dylanler/flour-dispenser-assembly/public/hardware/README.txt

Current build: V3.2. Open BUILD_GUIDE_V3_2.html.
Reprint only hopper/gate from servo-fit/V3_2_REPAIR_PLATE_HOPPER_GATE_PACKING.3mf; retain stand/lid/clips.
Wiring: wiring/WIRING_GUIDE.html. MicroPython: repository docs/SOFTWARE.md.
No servo-ear shims; supplied horn seats first, optional packing under horn arms in gate. Physically unverified prototype.
