dylanler/flour-dispenser-assembly/public/hardware/one_plate_preview.png

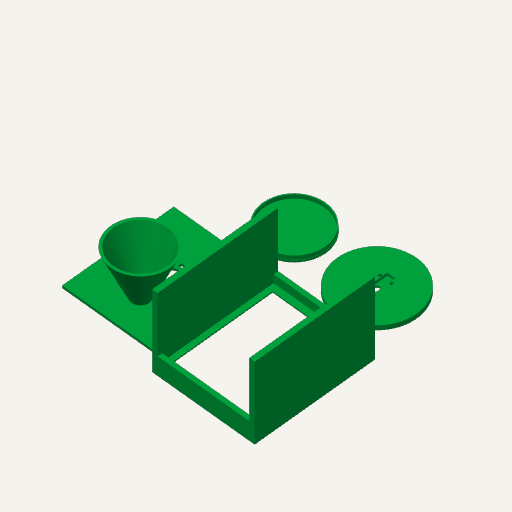
public/hardware/one_plate_preview.png
