dylanler/flour-dispenser-assembly/public/hardware/one_plate_preview_v3.png

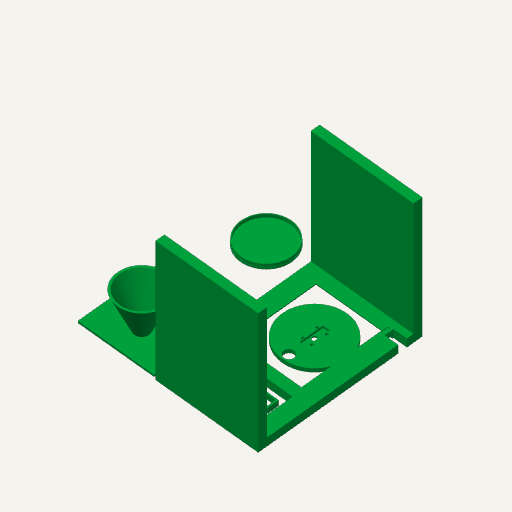
public/hardware/one_plate_preview_v3.png
