dylanler/flour-dispenser-assembly/public/hardware/simulation/overview.png

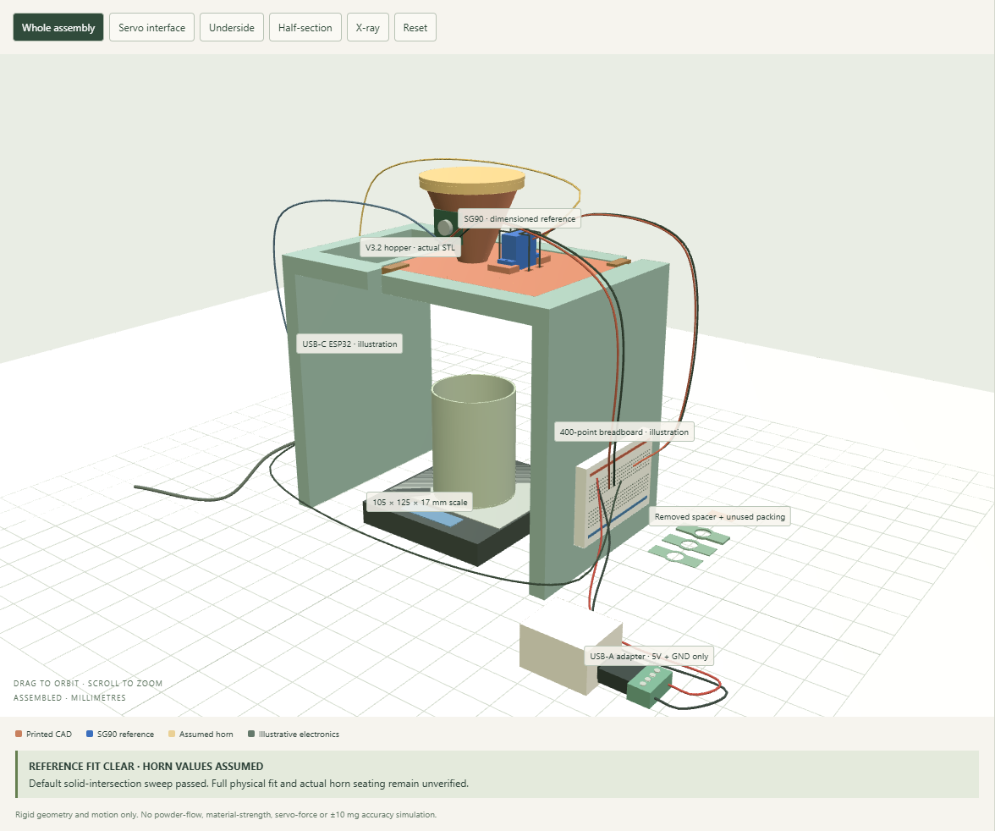
public/hardware/simulation/overview.png
