dylanler/flour-dispenser-assembly/public/hardware/simulation/section.png

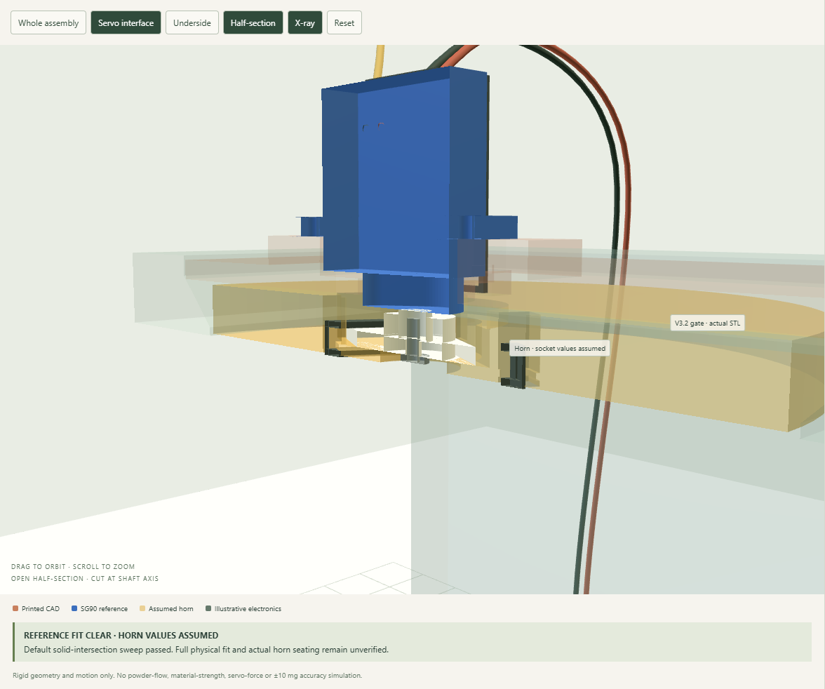
public/hardware/simulation/section.png
