dylanler/flour-dispenser-assembly/public/hardware/top_preview.png

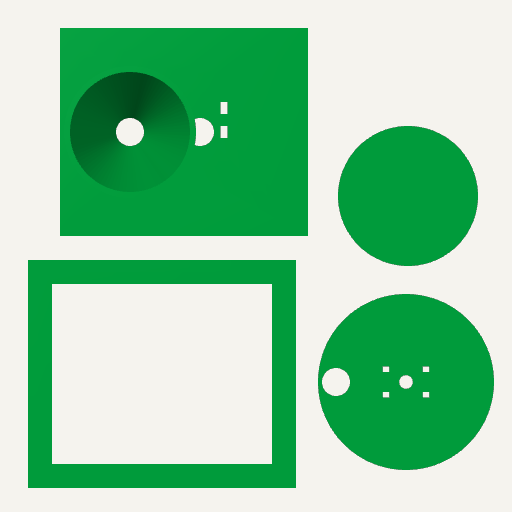
public/hardware/top_preview.png
