dylanler/flour-dispenser-assembly/public/hardware/top_preview_v3.png

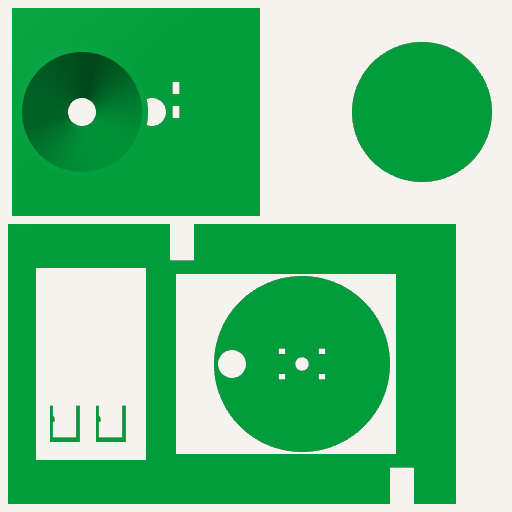
public/hardware/top_preview_v3.png
