dylanler/flour-dispenser-assembly/public/hardware/V3_ASSEMBLED_REFERENCE_DO_NOT_PRINT.stl

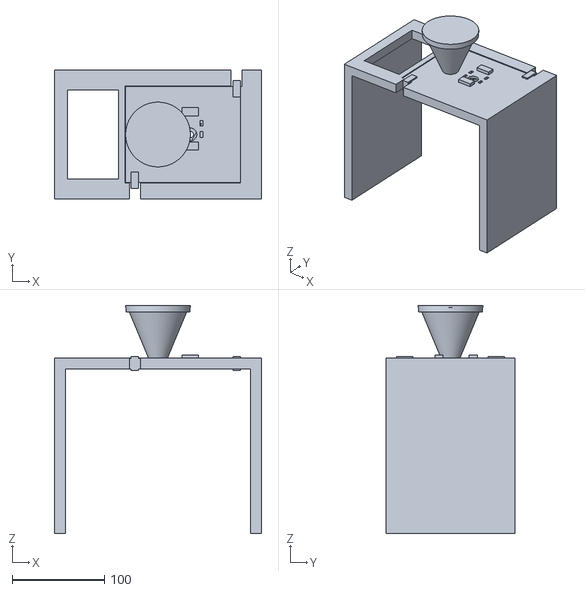
[picture p9: CAD file, 2026-11-04]
public/hardware/V3_ASSEMBLED_REFERENCE_DO_NOT_PRINT.stl
224.0 x 140.0 x 246.7
