dylanler/flour-dispenser-assembly/public/hardware/servo-fit/11_ASSEMBLY_GAP_SPACER_0p6_V3_2.stl

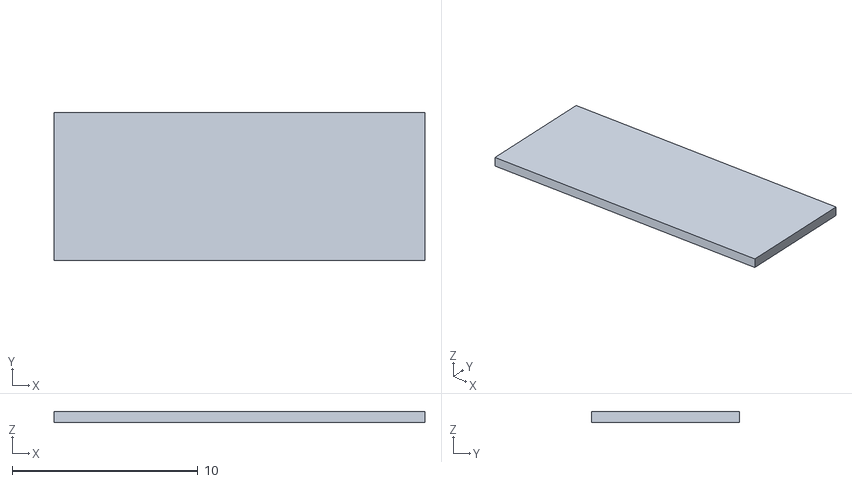
[picture p10: CAD file, 2026-11-10]
public/hardware/servo-fit/11_ASSEMBLY_GAP_SPACER_0p6_V3_2.stl
20.0 x 8.00 x 0.6
