dylanler/flour-dispenser-assembly/public/hardware/simulation/front_clip_assembled.stl

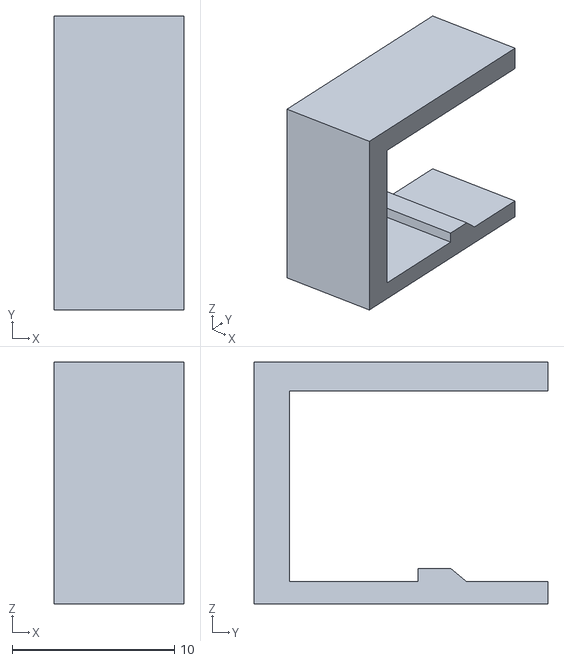
[picture p11: CAD file, 2026-11-10]
public/hardware/simulation/front_clip_assembled.stl
8.00 x 18.1 x 14.9
