dylanler/flour-dispenser-assembly/public/hardware/A1_V3_WIDE_ONE_PLATE.3mf

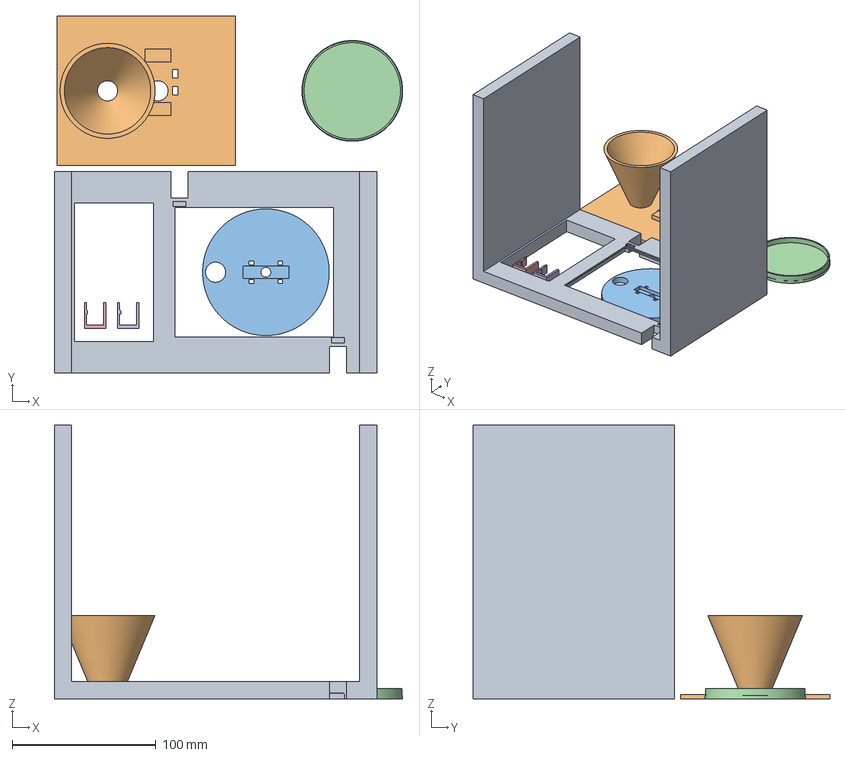
[picture p12: CAD file, 2026-11-04]
public/hardware/A1_V3_WIDE_ONE_PLATE.3mf
242.0 x 248.0 x 190.0 mm
01_wide_cradle
02_hopper_with_servo_mount
03_rotary_gate
04_lid
05_locking_clip x 2
