dylanler/flour-dispenser-assembly/public/hardware/servo-fit/09_GATE_ADJUSTABLE_HORN_V3_2.stl

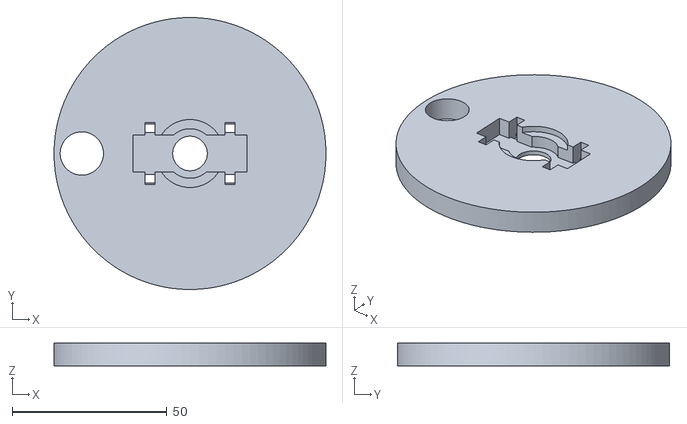
[picture p13: CAD file, 2026-11-10]
public/hardware/servo-fit/09_GATE_ADJUSTABLE_HORN_V3_2.stl
88.0 x 88.0 x 7.40
