dylanler/flour-dispenser-assembly/public/hardware/simulation/servo_ears.stl

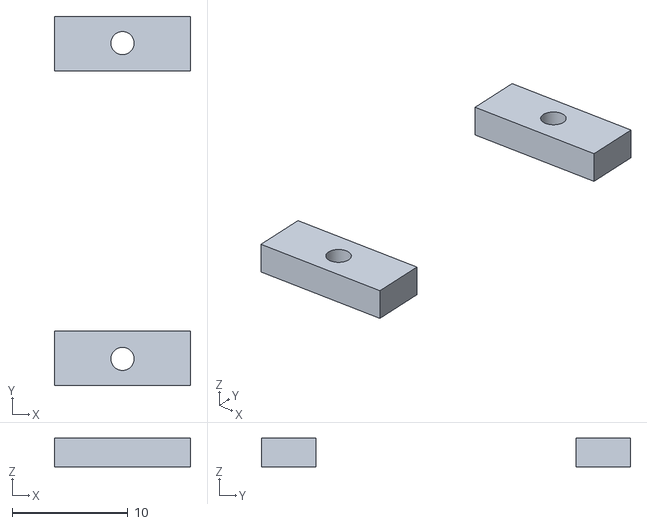
[picture p14: CAD file, 2026-11-10]
public/hardware/simulation/servo_ears.stl
11.8 x 31.9 x 2.50
