dylanler/flour-dispenser-assembly/public/hardware/stl/01_wide_cradle.stl

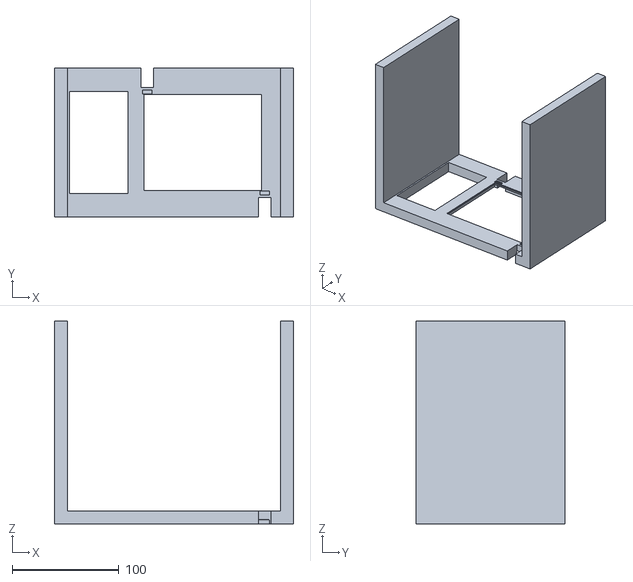
[picture p15: CAD file, 2026-11-04]
public/hardware/stl/01_wide_cradle.stl
224.0 x 140.0 x 190.0
