dylanler/flour-dispenser-assembly/public/hardware/simulation/horn_arms_35.stl

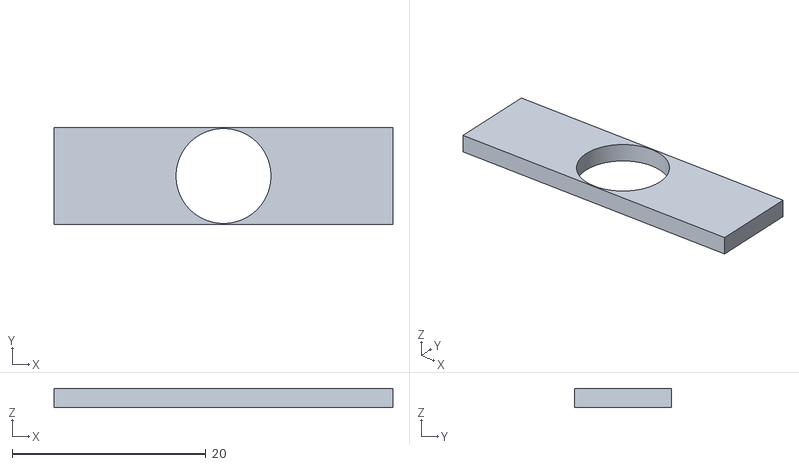
[picture p17: CAD file, 2026-11-10]
public/hardware/simulation/horn_arms_35.stl
35.0 x 10.0 x 2.00
