dylanler/flour-dispenser-assembly/public/hardware/A1_SIMPLE_V2_ONE_PLATE.3mf

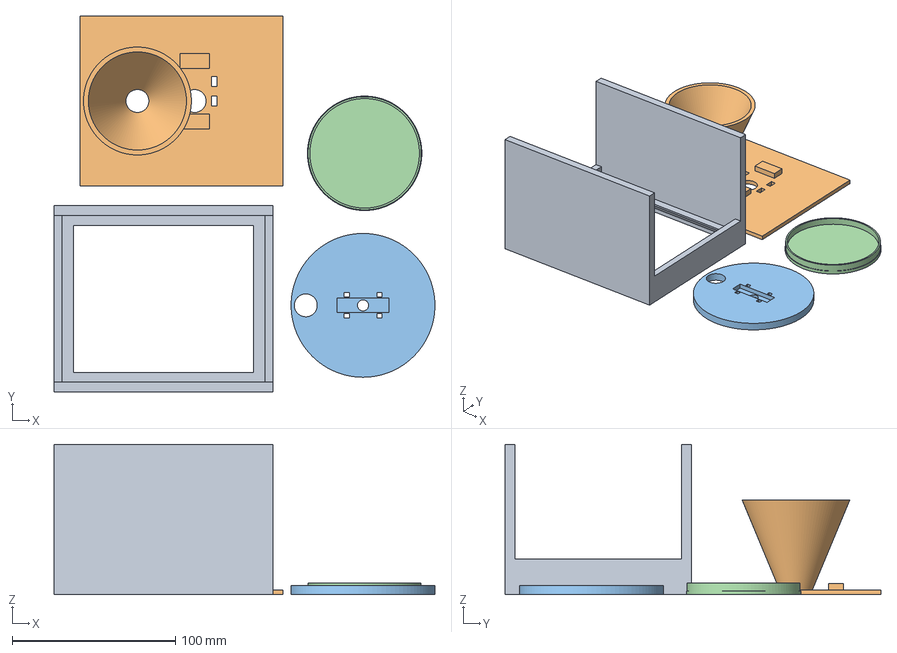
[picture p18: CAD file, 2026-11-04]
public/hardware/A1_SIMPLE_V2_ONE_PLATE.3mf
233.0 x 230.0 x 92.0 mm
01_drop_in_cradle
02_hopper_with_servo_mount
03_rotary_gate
04_lid
