dylanler/flour-dispenser-assembly/public/hardware/simulation/horn_arms_32.stl

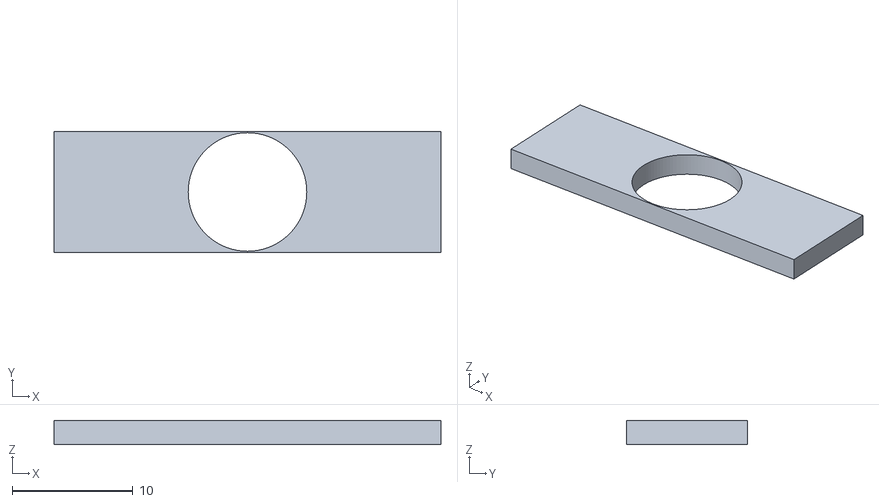
[picture p19: CAD file, 2026-11-10]
public/hardware/simulation/horn_arms_32.stl
32.0 x 10.0 x 2.00
