dylanler/flour-dispenser-assembly/public/hardware/stl/06_OPTIONAL_CLIP_FIT_COUPON.stl

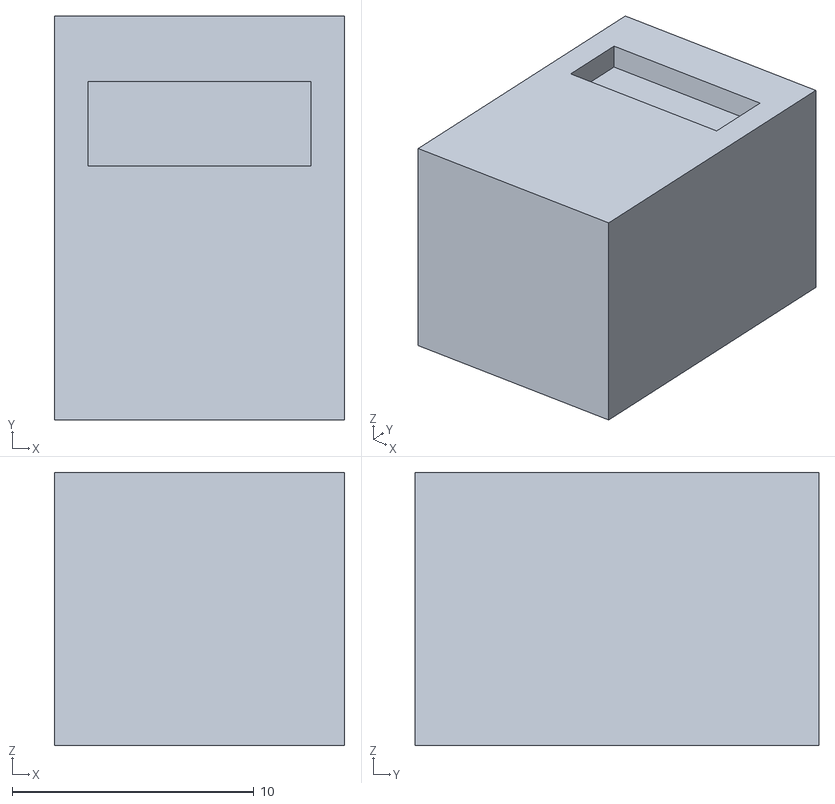
[picture p20: CAD file, 2026-11-04]
public/hardware/stl/06_OPTIONAL_CLIP_FIT_COUPON.stl
12.0 x 16.7 x 11.3
