dylanler/flour-dispenser-assembly/public/hardware/servo-fit/10_HORN_PACKING_0p4_V3_2.stl

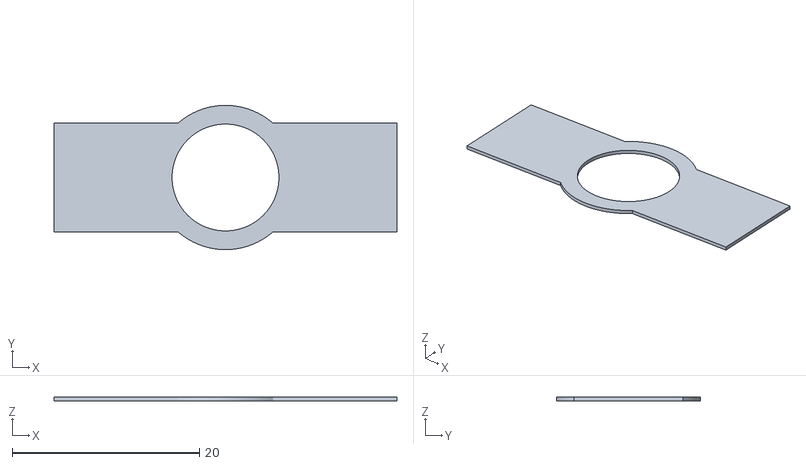
[picture p21: CAD file, 2026-11-10]
public/hardware/servo-fit/10_HORN_PACKING_0p4_V3_2.stl
36.6 x 15.4 x 0.4
