dylanler/flour-dispenser-assembly/public/hardware/stl/02_hopper_with_servo_mount.stl

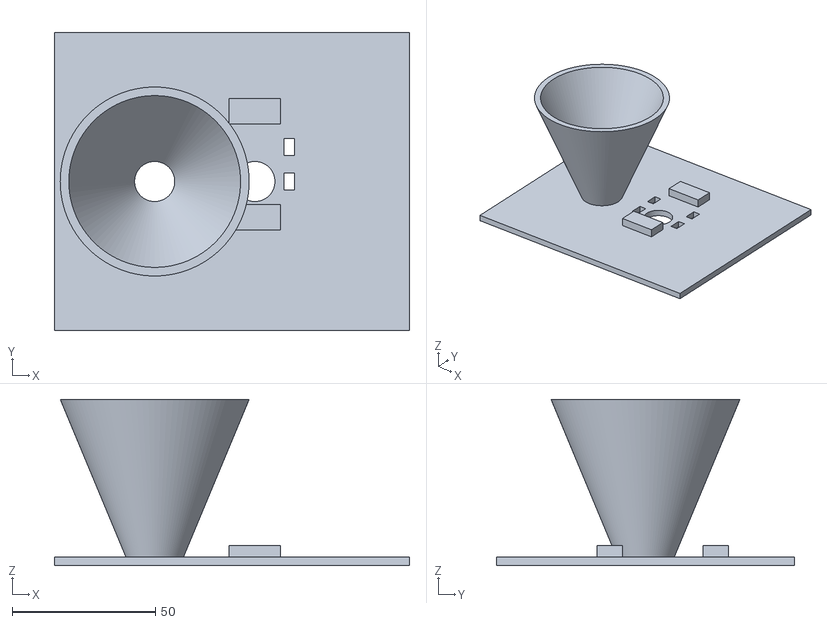
[picture p22: CAD file, 2026-11-04]
public/hardware/stl/02_hopper_with_servo_mount.stl
124.0 x 104.0 x 58.0
