dylanler/flour-dispenser-assembly/public/hardware/simulation/servo_shaft.stl

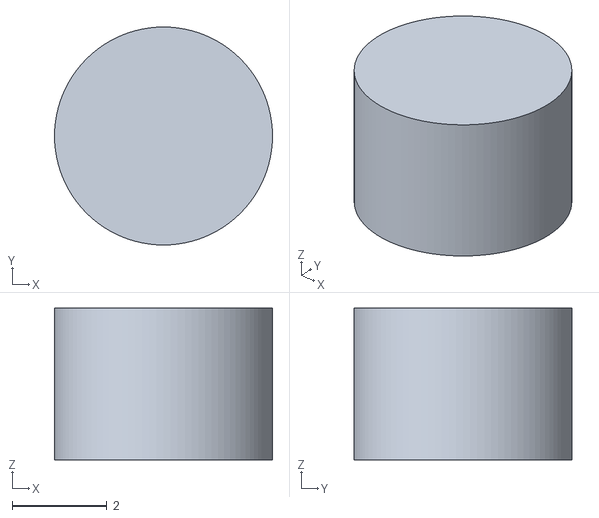
[picture p23: CAD file, 2026-11-10]
public/hardware/simulation/servo_shaft.stl
4.60 x 4.60 x 3.20
