dylanler/flour-dispenser-assembly/public/hardware/stl/01_drop_in_cradle.stl

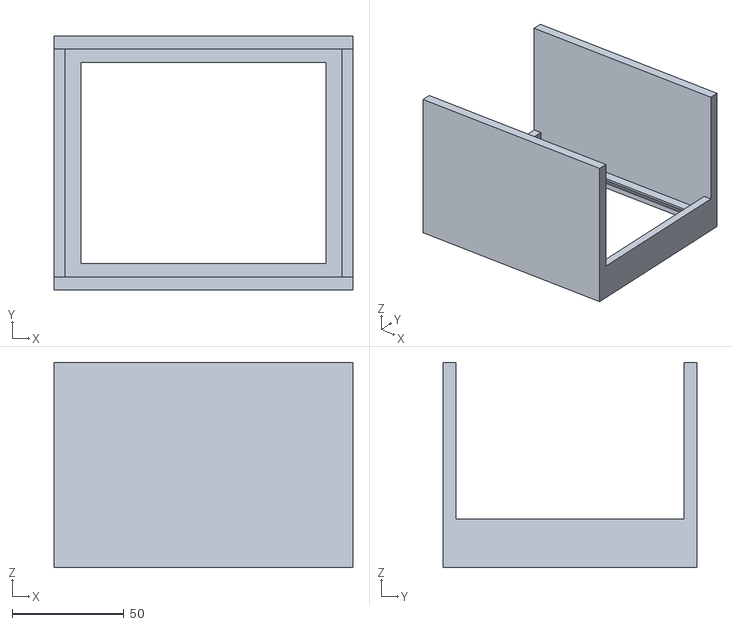
[picture p24: CAD file, 2026-11-04]
public/hardware/stl/01_drop_in_cradle.stl
134.0 x 114.0 x 92.0
