dylanler/flour-dispenser-assembly/public/hardware/servo-fit/V3_2_REPAIR_PLATE_HOPPER_GATE_PACKING.3mf

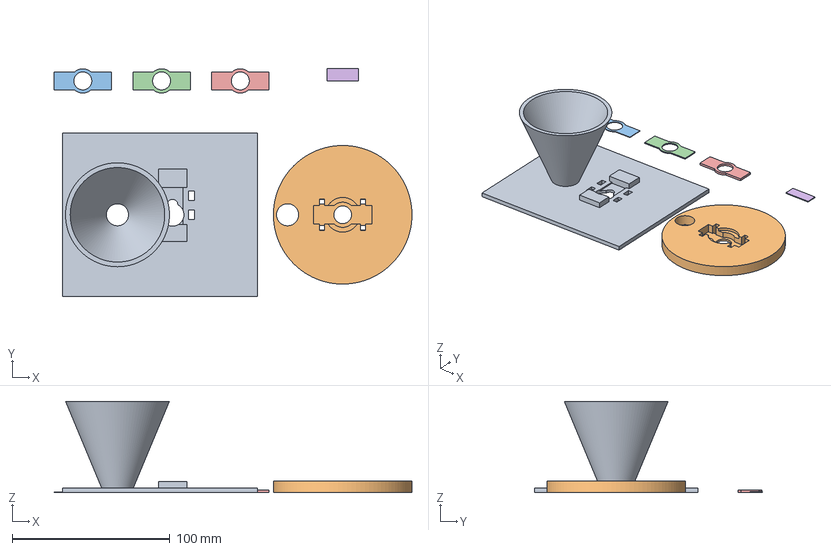
[picture p25: CAD file, 2026-11-10]
public/hardware/servo-fit/V3_2_REPAIR_PLATE_HOPPER_GATE_PACKING.3mf
227.3 x 145.0 x 58.0 mm
08_HOPPER_ORIGINAL_SERVO_HEIGHT_V3_2
09_GATE_ADJUSTABLE_HORN_V3_2
10_HORN_PACKING_0p4_V3_2
10_HORN_PACKING_0p8_V3_2
10_HORN_PACKING_1p6_V3_2
11_ASSEMBLY_GAP_SPACER_0p6_V3_2
