dylanler/flour-dispenser-assembly/public/hardware/simulation/horn_assumed_reference.stl

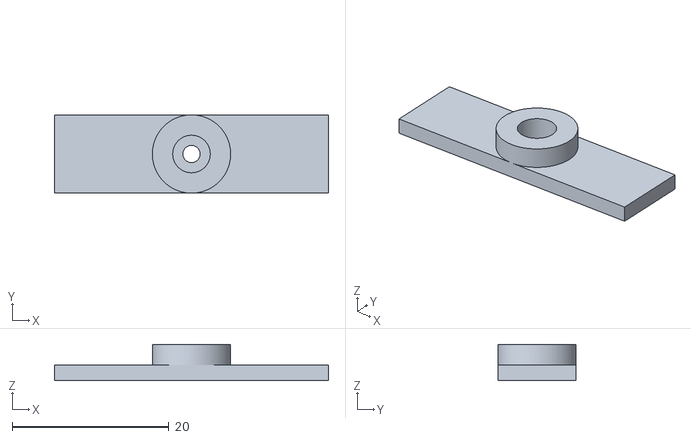
[picture p26: CAD file, 2026-11-10]
public/hardware/simulation/horn_assumed_reference.stl
35.0 x 10.0 x 4.60
