dylanler/flour-dispenser-assembly/public/hardware/stl/04_lid.stl

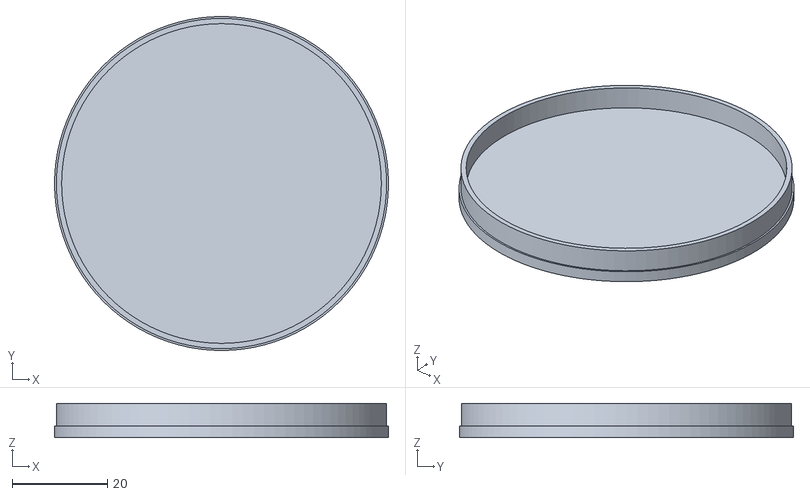
[picture p27: CAD file, 2026-11-04]
public/hardware/stl/04_lid.stl
70.0 x 70.0 x 7.20
