dylanler/flour-dispenser-assembly/public/hardware/servo-fit/10_HORN_PACKING_1p6_V3_2.stl

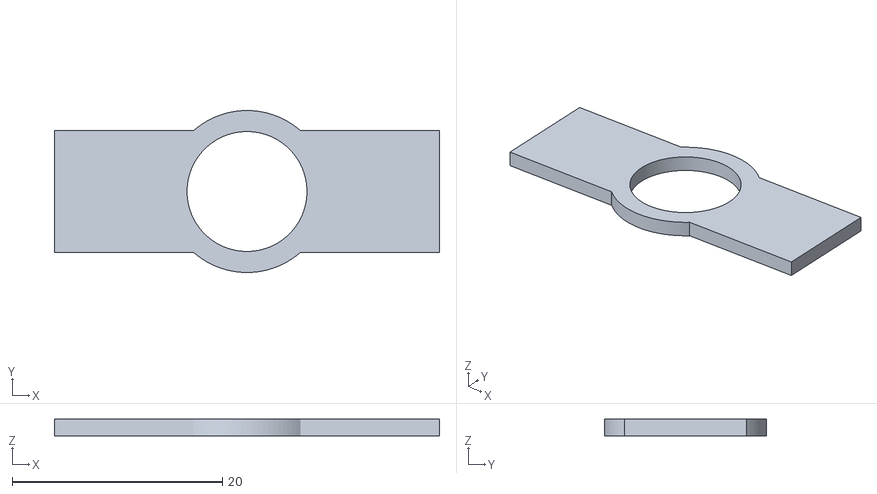
[picture p28: CAD file, 2026-11-10]
public/hardware/servo-fit/10_HORN_PACKING_1p6_V3_2.stl
36.6 x 15.4 x 1.60
