dylanler/flour-dispenser-assembly/public/hardware/simulation/servo_case.stl

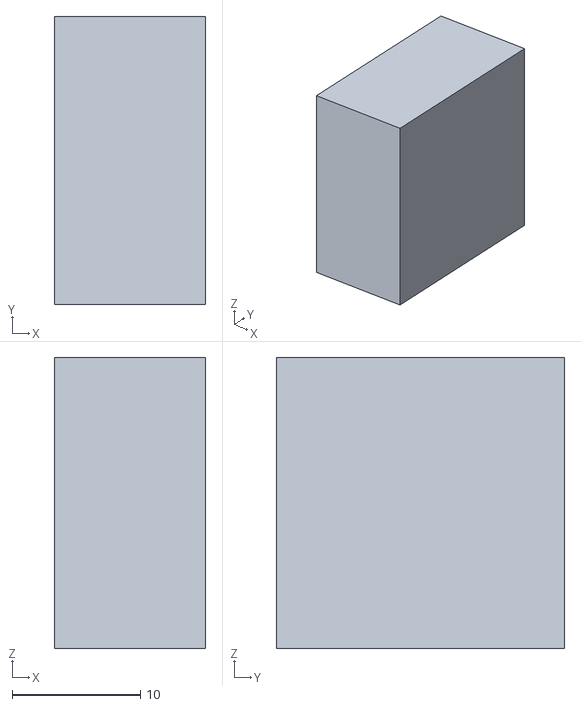
[picture p29: CAD file, 2026-11-10]
public/hardware/simulation/servo_case.stl
11.8 x 22.5 x 22.7
