dylanler/flour-dispenser-assembly/public/hardware/stl/03_rotary_gate.stl

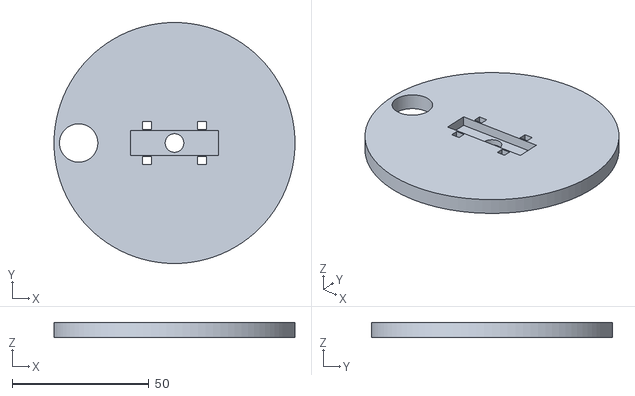
[picture p30: CAD file, 2026-11-04]
public/hardware/stl/03_rotary_gate.stl
88.0 x 88.0 x 5.50
