dylanler/flour-dispenser-assembly/public/hardware/simulation/gate_ties_reference.stl

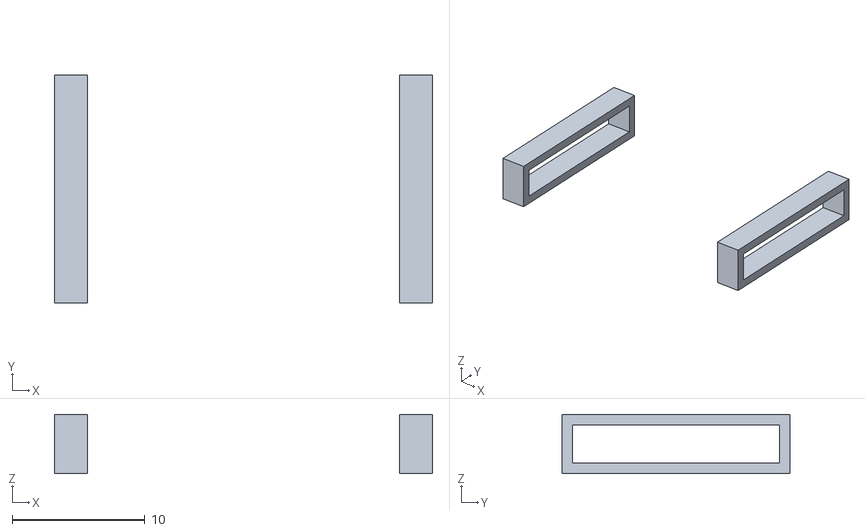
[picture p31: CAD file, 2026-11-10]
public/hardware/simulation/gate_ties_reference.stl
28.5 x 17.2 x 4.45
