dylanler/flour-dispenser-assembly/public/hardware/simulation/servo_boss.stl

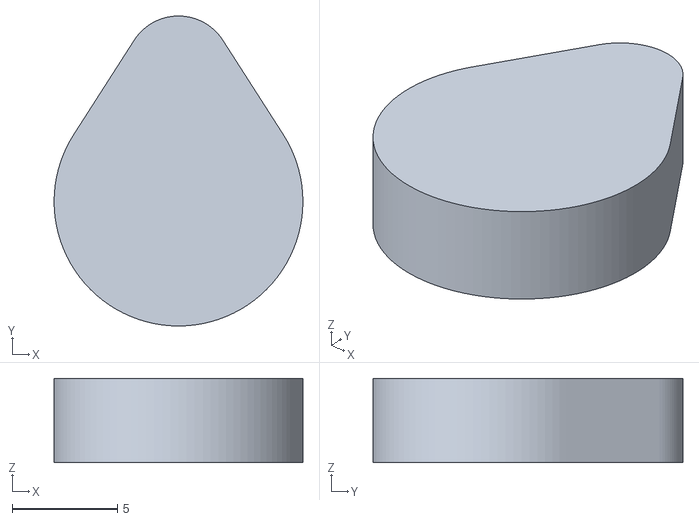
[picture p32: CAD file, 2026-11-10]
public/hardware/simulation/servo_boss.stl
11.8 x 14.7 x 4.00
