dylanler/flour-dispenser-assembly/public/hardware/servo-fit/01_BOSS_PROFILE_GAUGE_TEST_FIRST.stl

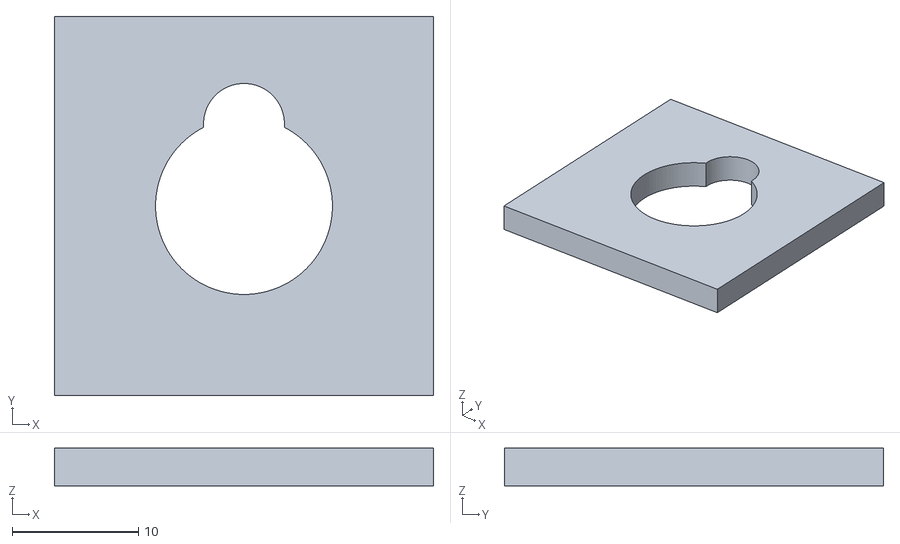
[picture p33: CAD file, 2026-11-08]
public/hardware/servo-fit/01_BOSS_PROFILE_GAUGE_TEST_FIRST.stl
30.0 x 30.0 x 3.00
