dylanler/flour-dispenser-assembly/public/hardware/simulation/servo_ties_reference.stl

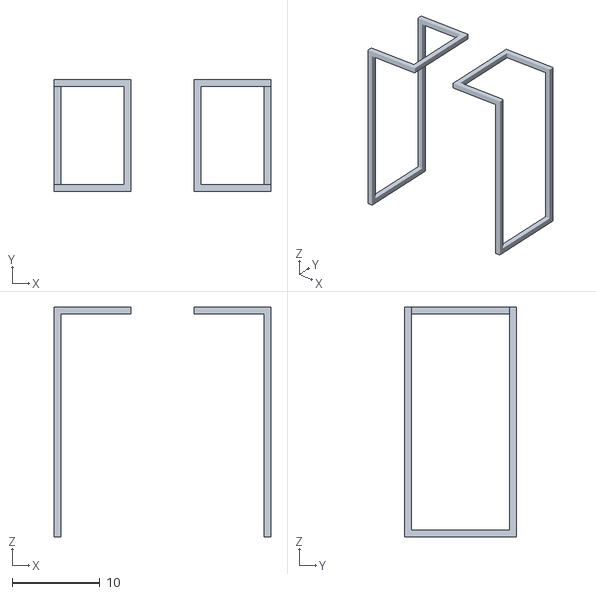
[picture p34: CAD file, 2026-11-10]
public/hardware/simulation/servo_ties_reference.stl
24.8 x 12.8 x 26.2
