dylanler/flour-dispenser-assembly/public/hardware/servo-fit/03_FAR_EAR_BRIDGE_1p4.stl

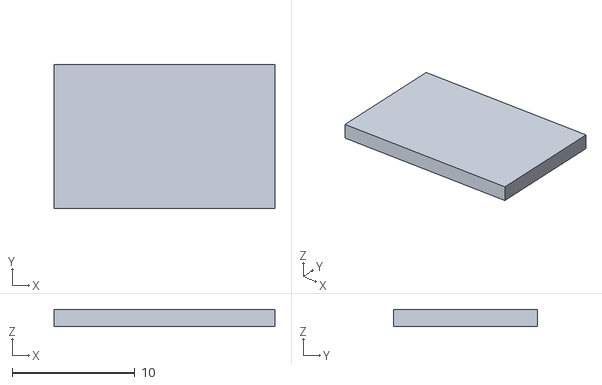
[picture p35: CAD file, 2026-11-08]
public/hardware/servo-fit/03_FAR_EAR_BRIDGE_1p4.stl
18.0 x 11.7 x 1.40
