dylanler/flour-dispenser-assembly/public/hardware/servo-fit/02_NEAR_EAR_BRIDGE_1p4.stl

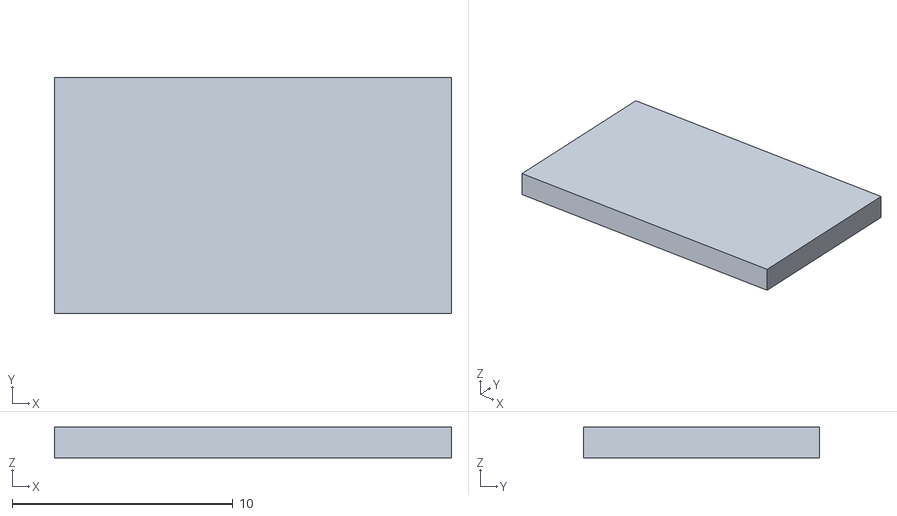
[picture p36: CAD file, 2026-11-08]
public/hardware/servo-fit/02_NEAR_EAR_BRIDGE_1p4.stl
18.0 x 10.7 x 1.40
