dylanler/flour-dispenser-assembly/public/hardware/servo-fit/03_FAR_EAR_BRIDGE_1p0.stl

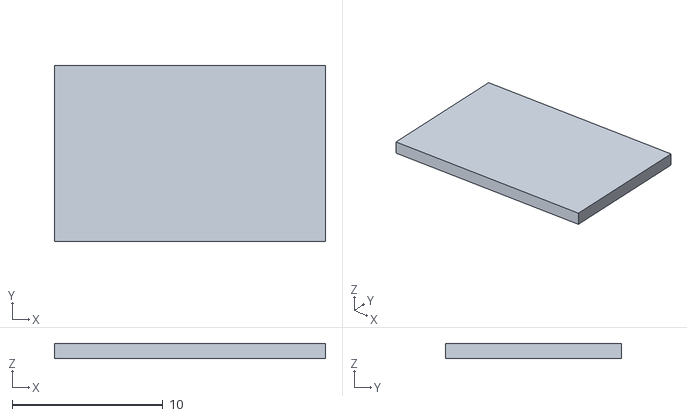
[picture p38: CAD file, 2026-11-08]
public/hardware/servo-fit/03_FAR_EAR_BRIDGE_1p0.stl
18.0 x 11.7 x 1.00
