dylanler/flour-dispenser-assembly/public/hardware/servo-fit/SG90_SMALL_FIT_TEST_KIT.3mf

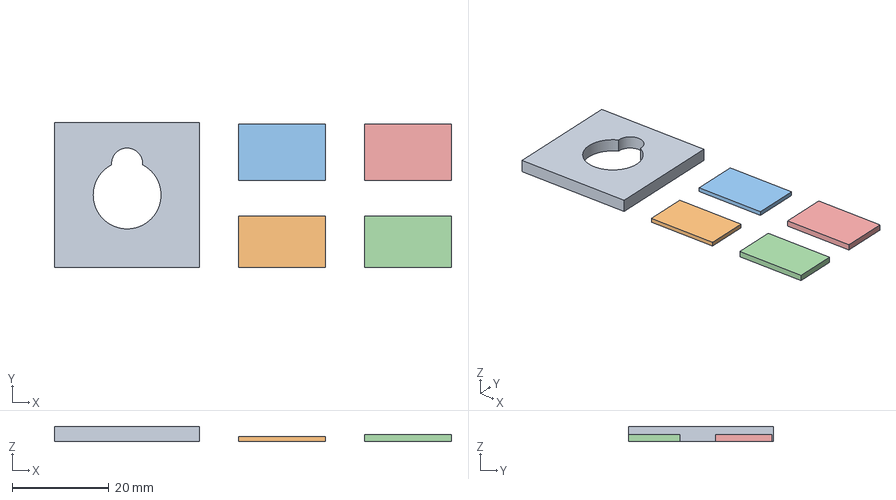
[picture p39: CAD file, 2026-11-08]
public/hardware/servo-fit/SG90_SMALL_FIT_TEST_KIT.3mf
82.0 x 30.0 x 3.00 mm
01_BOSS_PROFILE_GAUGE_TEST_FIRST
02_NEAR_EAR_BRIDGE_1p0
03_FAR_EAR_BRIDGE_1p0
02_NEAR_EAR_BRIDGE_1p4
03_FAR_EAR_BRIDGE_1p4
