dylanler/flour-dispenser-assembly/(list of files, cad)

Other CAD files:
public/hardware/simulation/rear_clip_assembled.stl
public/hardware/stl/05_locking_clip.stl
public/hardware/servo-fit/08_HOPPER_ORIGINAL_SERVO_HEIGHT_V3_2.stl
public/hardware/servo-fit/07_HOPPER_SG90_RELIEF_V3_1.stl
public/hardware/servo-fit/PRINT_THIS_HOPPER_ONLY_V3_1.3mf
public/hardware/A1_SIMPLE_V2_ONE_PLATE.stl
public/hardware/A1_V3_WIDE_ONE_PLATE.stl
