dylanler/flour-dispenser-assembly/public/assembly-film-preview.png

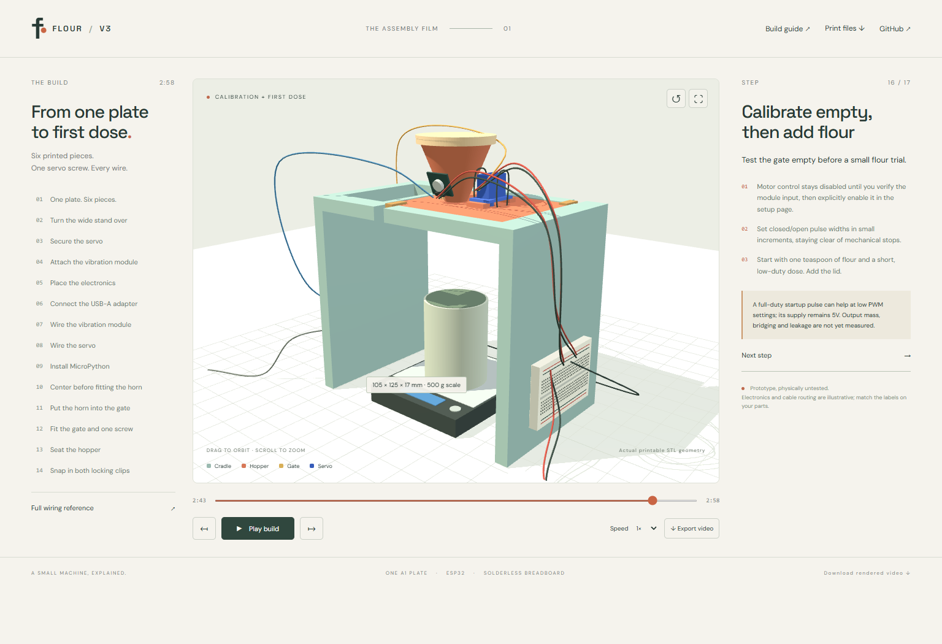
public/assembly-film-preview.png
