dylanler/flour-dispenser-assembly/public/hardware/assembly-v3-2/gate-approach.png

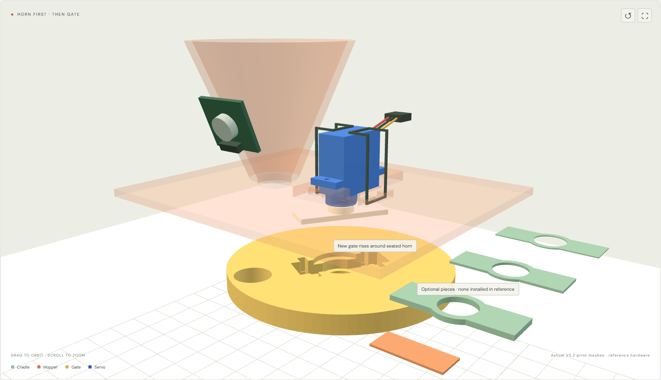
public/hardware/assembly-v3-2/gate-approach.png
