dylanler/flour-dispenser-assembly/public/hardware/assembly-v3-2/step-03.png

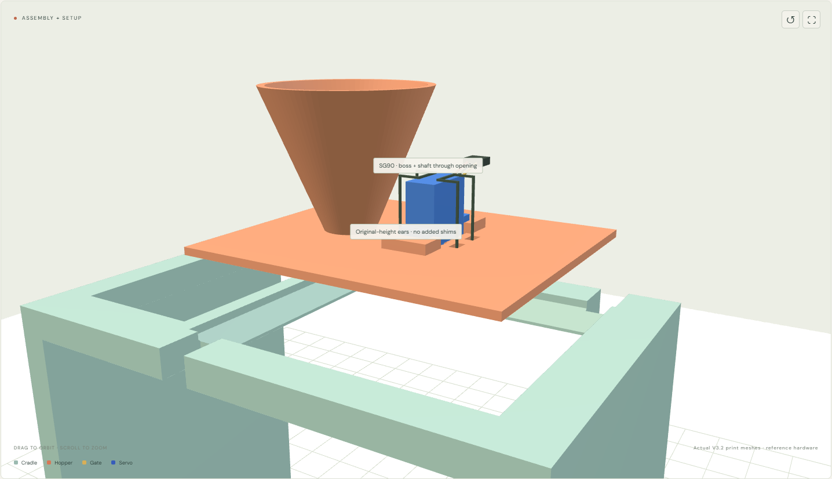
public/hardware/assembly-v3-2/step-03.png
