dylanler/flour-dispenser-assembly/public/hardware/assembly-v3-2/step-06.png

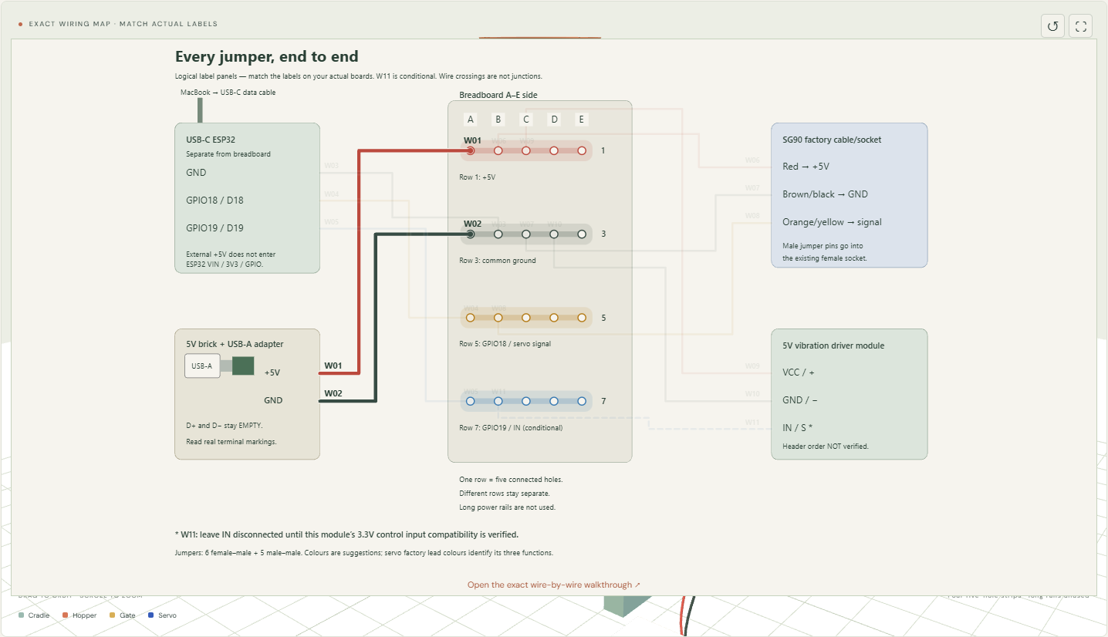
public/hardware/assembly-v3-2/step-06.png
