dylanler/flour-dispenser-assembly/public/hardware/assembly_preview.png

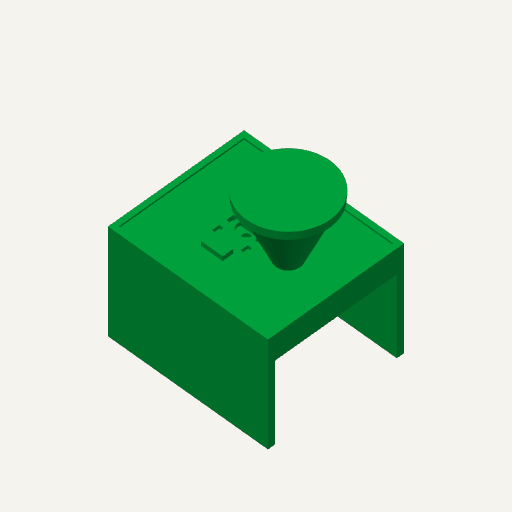
public/hardware/assembly_preview.png
