dylanler/flour-dispenser-assembly/public/hardware/assembly_preview_v3.png

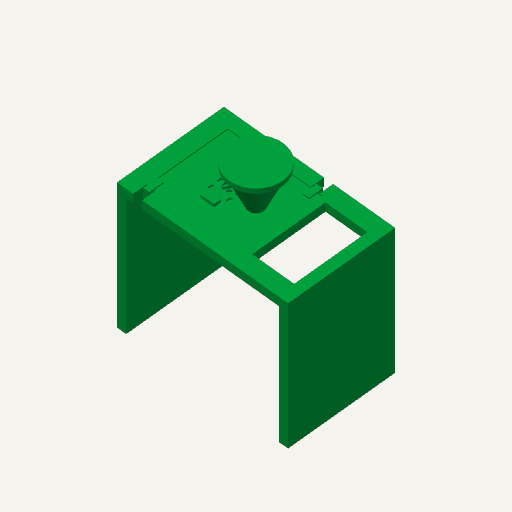
public/hardware/assembly_preview_v3.png
