dylanler/flour-dispenser-assembly/docs/VALIDATION.md

# Validation scope

**Known physical fit failure, reported 2026-11-07:** the SG90 gearbox tail does not clear the original 14 mm round opening. The older servo model omitted this tail. Reference-drawing checks also find a mounting-height risk. Original printed-part mesh and slicer checks did not establish component fit. See [SERVO_FIT_AUDIT.md](SERVO_FIT_AUDIT.md). The small diagnostic kit is drawing-based, about 3.45 g of PETG, and is not physically verified.

## V3 geometry and scale bay

The V3 generator verifies six separate watertight connected pieces (five unique models), all inside the 256 mm A1 bed, including nested parts. It tests nominal assembled meshes for interference through a −70° to +70° gate sweep with both clips installed. It also checks that a 1 mm rigid withdrawal hits each clip hook's recess wall and a 1 mm hopper lift hits each upper jaw. These establish geometric capture, **not** spring behavior or retention force.

The known 105 × 125 × 17 mm scale envelope clears the stand. A solid Ø60 × 80 mm example cup, raised 15 mm above the scale and moved through the front opening, clears the printed mechanism in the checked path. The actual cup/gripper/robot are unspecified and are not validated by that example.

Actual Bambu Studio V3 slicing reports six objects inside the plate, no supports, **463.94 g / 53,611 seconds** (14 h 53 min 31 s). The new stand footprint is 224 × 140 mm and its height is 190 mm; inner width is 200 mm. V3 reports are `validation_v3.json` and `slicer_validation_v3.json`. The standalone CAD generator is also run in CI.

No physical tests have established the clips' insertion force, release force, fatigue life, layer strength, or retention during vibration. The nominal hook engagement is 0.6 mm, with a 0.8 mm-high hook. Tight fits require adjustment rather than force. Keep the scale independent of the stand and stop vibration before reading it. An optional 11.3 mm stack coupon with the matching recess is provided for a small physical clip-fit test; it is excluded from the six-piece full plate.

## Software checks completed

- Production Vite build succeeded with Node 22.23.4; npm audit reported zero known vulnerabilities at installation time.
- Four JavaScript tests cover timeline boundaries, key assembly constraints, correct screw-terminal wire exits and clearance of the complete curved leads from the brick. The wire test samples the actual Three.js Catmull–Rom curves, including their tube radius, rather than just checking control points.
- Eight CPython unit/integration tests exercise the actual controller and HTTP handler with mocked PWM hardware: boot state, unverified motor rejection, gate-only operation, startup kick, dose deadline, arm expiry, duplicate-dose rejection, input bounds, calibration, configuration and Stop.
- Headless Chrome loaded the actual STL scene with no page errors. All 17 chapter buttons, previous/next, playback/pause, desktop layout and 390 px mobile layout were checked. Browser control-page checks confirmed that calibration, motor verification and dose inputs produce the intended JSON requests.
- The app exported a captioned WebM walkthrough from its own Three.js renderer. Source geometry is the supplied print geometry; electronics/cable illustrations are approximate.

Optional reproducible browser checks are in `scripts/browser_check.py`; see its header for Playwright setup. They are separate from the hardware setup requirements. A development server must be running first.

## Inherited digital hardware checks

The mesh and slicer reports in `public/hardware/` describe the existing printable V2 model. They report watertight connected pieces, valid plate placement, nominal 0.6 mm gate gap and interference-free printed geometry through the checked sweep. Prior Bambu Studio slicing used A1 / 0.4 mm, 0.2 mm layers, 3 walls, 5 top/bottom layers, 20% gyroid, no supports; estimate 220.75 g and 23,459 seconds.

Those results do not include SG90 clone dimensions, mounting tape, wires or retention-band force. Source CAD regenerates the printable model; it does not regenerate a Bambu printer profile.

## Still requires the actual parts

This repository has not been flashed to the purchased ESP32. GPIO voltage compatibility of the exact vibration module, servo pulse mapping, horn/shim fit, USB/CH340 behavior, supply performance, adhesion, locking clips, flour flow and sealing have not been physically tested. MicroPython code was syntax checked and exercised through hardware mocks, not executed on this ESP32.

Do not interpret a passing simulation, browser test or firmware test as a measured dispensing result. Follow the arrival checks and small supervised flour trial in the guide.

## Current V3.2 fit laboratory

The actual V3.2 print meshes are unchanged. `scripts/build_fit_simulation.py` exports source-labelled SG90 reference meshes and a smooth-bore assumed horn. Its full assembly static/sweep check evaluates 1197 pairs across29 gate positions with no unintended intersection above0.02 mm3 in the default model. Three negative controls detect deliberately inserted gate/flange overlap, a shallow horn socket and an oversized arm. Do not treat those checks as actual purchased-unit fit verification.

Interactive viewer: `fit-check.html`. `npm test` includes four independent fit/aperture tests. Optional browser QA: `python scripts/check_fit_simulation.py --url http://127.0.0.1:4188/fit-check.html`. Verified whole/interface/underside/section/x-ray views, animation, socket bottoming warning, excessive gap warning, gate interference warning, visibility controls, local links and mobile resize. Overview and section screenshots are in `public/hardware/simulation/`.

Live socket/packing edits are analytic geometry previews, not fresh solid booleans. Default mouth gap0.6, depth2.8 and hubOD10 are assumed. A 2 mm overlap screening threshold is not a manufacturer requirement. Electronics/screw/cables are illustrative and excluded from numerical validation; scale/cup are simplified envelopes. No FE/clip/tie mechanics, real spline/threads, powder dynamics or dosing accuracy is simulated.

The current target is larger doses +/-10 mg, superseding1mg. See the linked feasibility assessment. Existing firmware is open loop; the pocket scale has no data connection. Success in a geometry/browser test does not establish dispensing performance.

Additional continuous nominal-rotation check: rotationally invariant conservative envelopes for the gate, horn and gate ties clear all12 static solids. This covers static interference between sampled angles for default parameters. Moving-part relative positions stay fixed. It does not establish tolerances or real horn dimensions.

## Numbered wiring guide (2026-11-10)

`scripts/build_wiring_guide.py` generates W01–W11 data and two SVGs. Assertions check unique occupied holes, separate power/signal strips, required ground/power membership, six F–M and five M–M leads, GPIO18/19 against firmware, and every drawn wire endpoint against its assigned breadboard hole. This is netlist/drawing consistency, not physical electrical testing.

`python scripts/check_wiring_guide.py` verified all11 individual highlights, previous/next/reset-to-all navigation, the conditional W11 notice, diagram/data/assembly links, mobile width and absence of page errors. Root animation and fit viewer browser checks plus8 JavaScript/8 Python tests also passed. Header order and the exact motor module input circuit remain unverified.
Current full assembly (2026-11-11): 17 shared-data steps in assembly-steps.js; actual V3.2 print meshes in scene-v32.js. Captured every step, checked actual 08/09 paths and all eleven jumper IDs, verified horn visibility before gate installation and the -7.9 mm gate-root reference pose. Both generated guide aliases load all figures. The new 1280x960 captioned video is a 94.601-second 2x overview, remuxed without re-encoding to finalize duration/seek metadata. Browser animation, wiring and fit-view checks plus 8 JS/8 Python tests pass. Physical fit/performance remains unverified. No print geometry changed. Optional media regeneration: capture_assembly_v32.py --record, then remux the WebM with ffmpeg -c copy for finite duration/seeking.
