dylanler/flour-dispenser-assembly/(commit log)

2026-11-04 Build flour dispenser assembly film, print package and MicroPython controller
    [01_drop_in_cradle.stl, 02_hopper_with_servo_mount.stl, 03_rotary_gate.stl, 04_lid.stl, A1_SIMPLE_V2_ONE_PLATE.3mf, A1_SIMPLE_V2_ONE_PLATE.stl]
2026-11-04 Add wide V3 scale bay and printed locking clips with robot access
    [01_wide_cradle.stl, 05_locking_clip.stl, 06_OPTIONAL_CLIP_FIT_COUPON.stl, A1_V3_WIDE_ONE_PLATE.3mf, A1_V3_WIDE_ONE_PLATE.stl, V3_ASSEMBLED_REFERENCE_DO_NOT_PRINT.stl]
2026-11-04 Use four-terminal USB-A adapter and correct power connector wire routing
2026-11-08 Record schematic-first hardware rules and add small SG90 salvage fit kit
    [01_BOSS_PROFILE_GAUGE_TEST_FIRST.stl, 02_NEAR_EAR_BRIDGE_1p0.stl, 02_NEAR_EAR_BRIDGE_1p4.stl, 03_FAR_EAR_BRIDGE_1p0.stl, 03_FAR_EAR_BRIDGE_1p4.stl, SG90_SMALL_FIT_TEST_KIT.3mf]
2026-11-08 Add hopper-only SG90 relief revision and replacement instructions
    [07_HOPPER_SG90_RELIEF_V3_1.stl, PRINT_THIS_HOPPER_ONLY_V3_1.3mf]
2026-11-10 Audit raised servo shaft stack and withdraw unverified print recommendation
2026-11-10 Add original-height SG90 repair with adjustable horn gate and tie clearances
    [08_HOPPER_ORIGINAL_SERVO_HEIGHT_V3_2.stl, 09_GATE_ADJUSTABLE_HORN_V3_2.stl, 10_HORN_PACKING_0p4_V3_2.stl, 10_HORN_PACKING_0p8_V3_2.stl, 10_HORN_PACKING_1p6_V3_2.stl, 11_ASSEMBLY_GAP_SPACER_0p6_V3_2.stl, V3_2_REPAIR_PLATE_HOPPER_GATE_PACKING.3mf]
2026-11-10 Add full V3.2 fit simulation, collision audit and 10mg feasibility assessment
    [front_clip_assembled.stl, gate_ties_reference.stl, horn_arms_32.stl, horn_arms_35.stl, horn_assumed_reference.stl, rear_clip_assembled.stl, servo_boss.stl, servo_case.stl]
2026-11-11 Add numbered end-to-end wiring walkthrough and breadboard hole maps
2026-11-11 Rebuild current V3.2 assembly sequence, illustrated guide and captioned video
